leanderseige/cableshieldtestinator/images/social.jpg

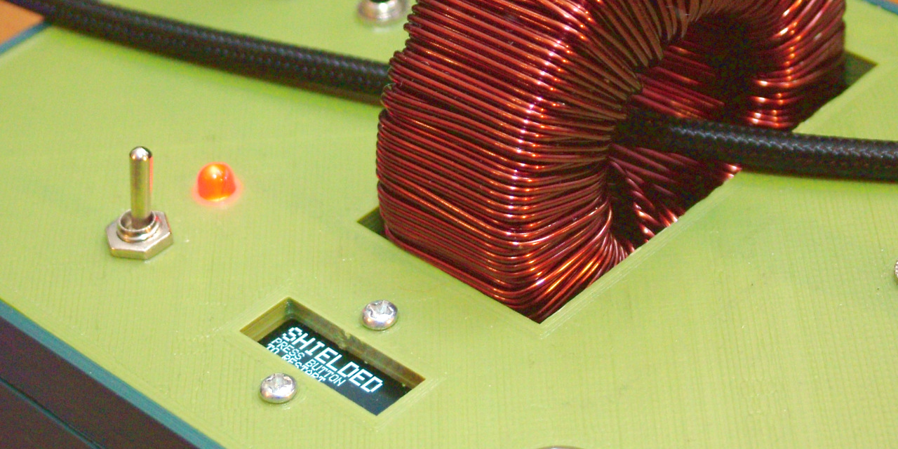
images/social.jpg
